pskowronek/unitra-fm-radio-arduino/www/assembled/01.jpg

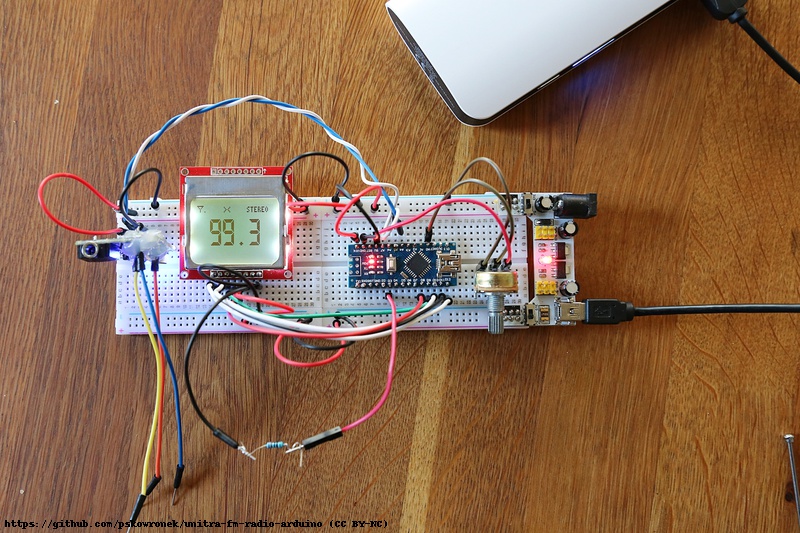
www/assembled/01.jpg
