pskowronek/unitra-fm-radio-arduino/www/assembled/02.jpg

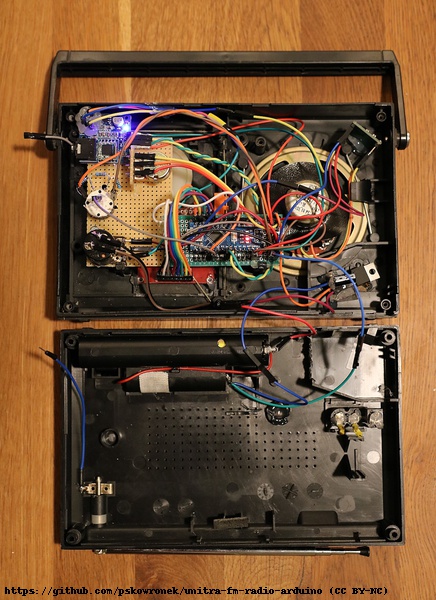
www/assembled/02.jpg
