pskowronek/unitra-fm-radio-arduino/www/assembled/03.jpg

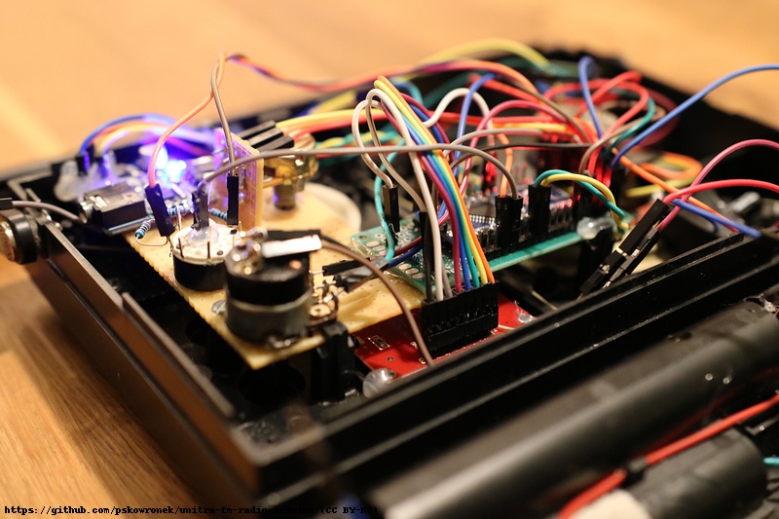
www/assembled/03.jpg
