pskowronek/unitra-fm-radio-arduino/www/assembled/04.jpg

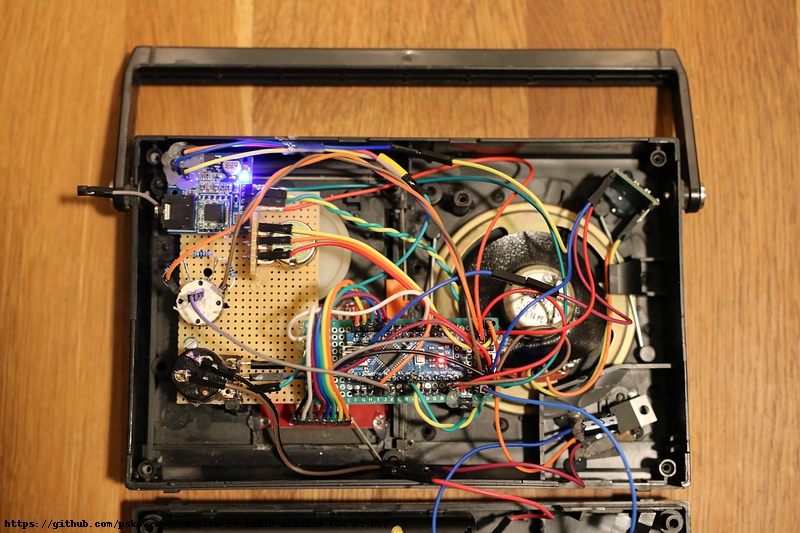
www/assembled/04.jpg
