pskowronek/unitra-fm-radio-arduino/www/assembled/05.jpg

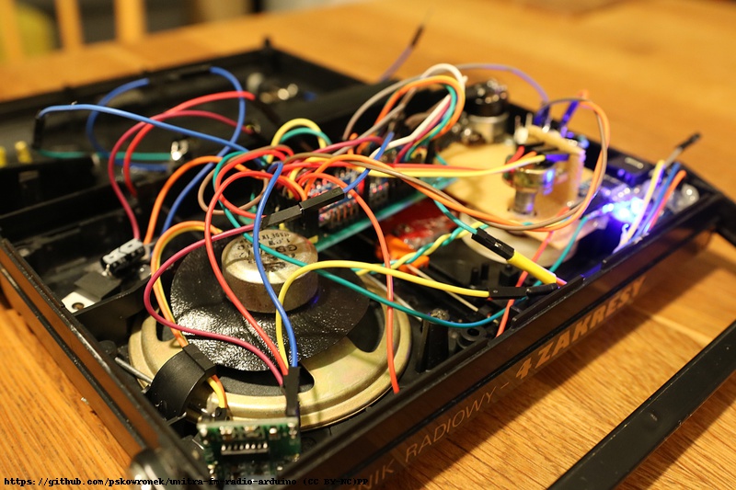
www/assembled/05.jpg
