pskowronek/unitra-fm-radio-arduino/www/assembled/06.jpg

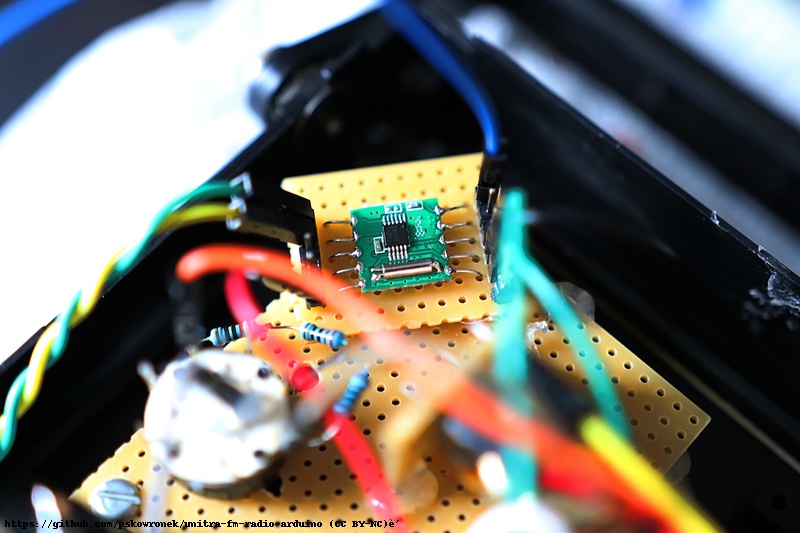
www/assembled/06.jpg
