pskowronek/unitra-fm-radio-arduino/www/assembled/07.jpg

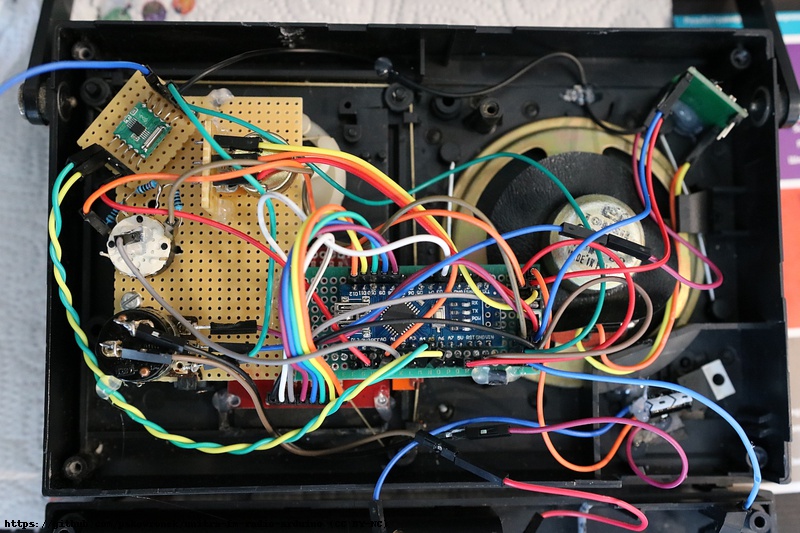
www/assembled/07.jpg
