pskowronek/unitra-fm-radio-arduino/www/assembled/08.jpg

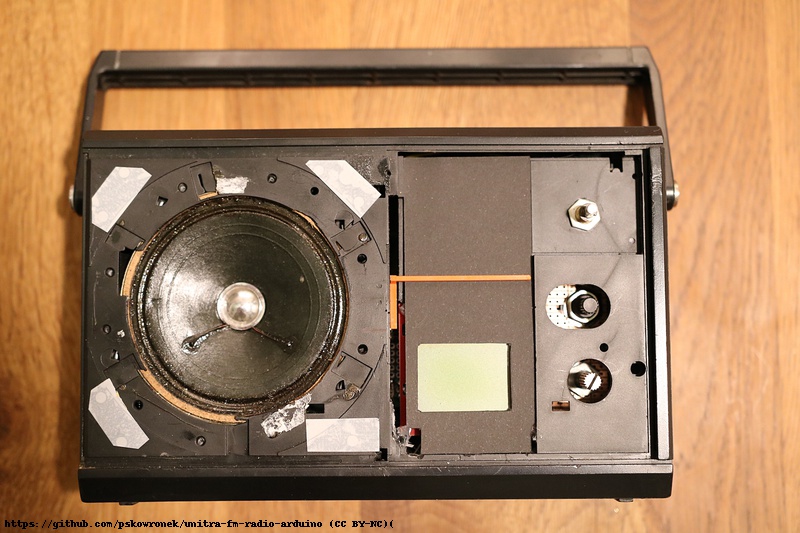
www/assembled/08.jpg
