pskowronek/unitra-fm-radio-arduino/www/assembled/10.jpg

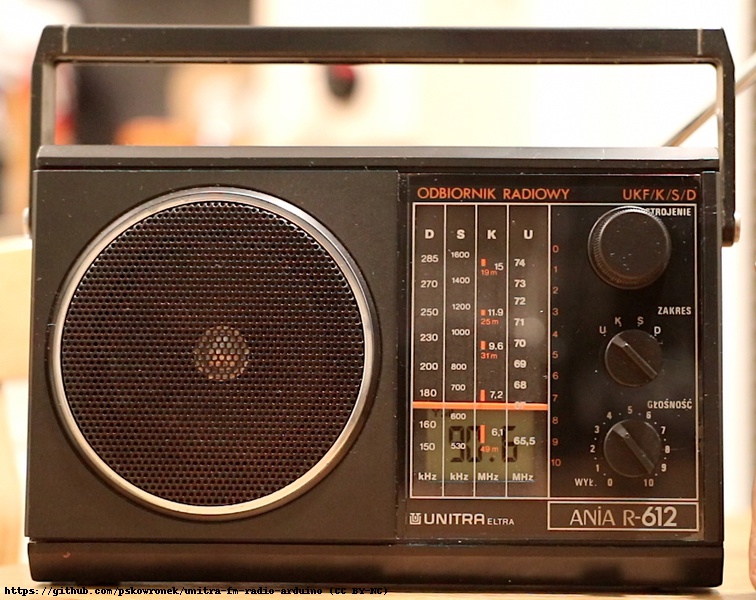
www/assembled/10.jpg
