pskowronek/unitra-fm-radio-arduino/www/assembled/thumbs/01.jpg

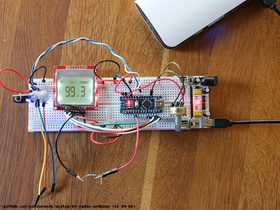
www/assembled/thumbs/01.jpg
