pskowronek/unitra-fm-radio-arduino/www/assembled/thumbs/02.jpg

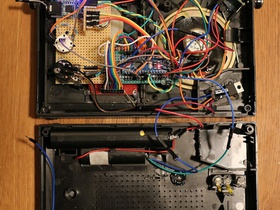
www/assembled/thumbs/02.jpg
