pskowronek/unitra-fm-radio-arduino/www/assembled/thumbs/03.jpg

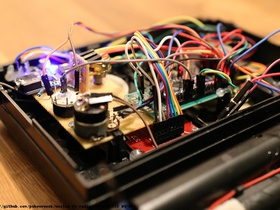
www/assembled/thumbs/03.jpg
