pskowronek/unitra-fm-radio-arduino/www/assembled/thumbs/04.jpg

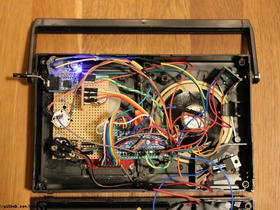
www/assembled/thumbs/04.jpg
