pskowronek/unitra-fm-radio-arduino/www/assembled/thumbs/05.jpg

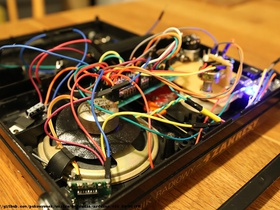
www/assembled/thumbs/05.jpg
