pskowronek/unitra-fm-radio-arduino/www/assembled/thumbs/06.jpg

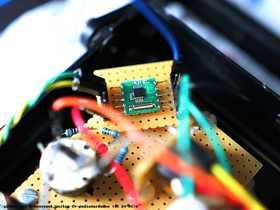
www/assembled/thumbs/06.jpg
