pskowronek/unitra-fm-radio-arduino/www/assembled/thumbs/07.jpg

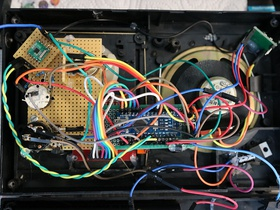
www/assembled/thumbs/07.jpg
