pskowronek/unitra-fm-radio-arduino/www/assembled/thumbs/08.jpg

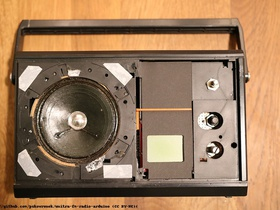
www/assembled/thumbs/08.jpg
