pskowronek/unitra-fm-radio-arduino/www/assembled/thumbs/09.jpg

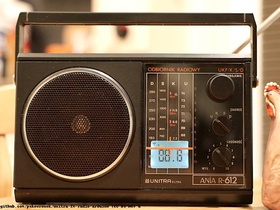
www/assembled/thumbs/09.jpg
