pskowronek/unitra-fm-radio-arduino/splash.c

#include <avr/pgmspace.h>

const unsigned char splash []PROGMEM  = {
0x00, 0x00, 0x00, 0x00, 0x00, 0x00, 0x00, 0x00, 0x00, 0x00, 0x00, 0x00, 0x00, 0x00, 0x00, 0x00,
0x00, 0x00, 0x00, 0x00, 0x00, 0x00, 0x00, 0x00, 0x00, 0x80, 0x80, 0x80, 0x80, 0xC0, 0xC0, 0x40,
0x60, 0x60, 0x20, 0x20, 0x30, 0x10, 0x10, 0x1C, 0x3E, 0x3E, 0x3E, 0x1C, 0x00, 0x00, 0x00, 0x00,
0x00, 0x00, 0x00, 0x00, 0x00, 0x80, 0x80, 0x80, 0x80, 0x80, 0x80, 0x80, 0x80, 0x80, 0x00, 0x80,
0x80, 0x80, 0x80, 0x00, 0x00, 0x00, 0x00, 0x80, 0x80, 0x80, 0x80, 0x00, 0x00, 0x00, 0x00, 0x00,
0x00, 0x00, 0x00, 0x00, 0x00, 0x00, 0x00, 0x00, 0x80, 0xE0, 0xF0, 0xF0, 0xF0, 0xF0, 0xF0, 0x98,
0x98, 0x98, 0x8C, 0x8C, 0x8C, 0x8C, 0x86, 0x86, 0x86, 0x83, 0x83, 0x83, 0x81, 0x81, 0x81, 0x80,
0x80, 0x80, 0x80, 0x80, 0x80, 0x80, 0x80, 0x80, 0x80, 0x80, 0x80, 0x80, 0x80, 0x80, 0x80, 0x00,
0x00, 0x00, 0x00, 0x00, 0x00, 0x00, 0x00, 0x00, 0x00, 0xFF, 0xFF, 0xFF, 0xE3, 0xE3, 0xE3, 0xE3,
0x03, 0x03, 0xE0, 0xFF, 0xFF, 0x7F, 0x7F, 0xFC, 0xE0, 0xC0, 0xF8, 0xFF, 0x1F, 0xFF, 0xFF, 0xFC,
0x00, 0x00, 0x00, 0x00, 0x00, 0x00, 0x00, 0x00, 0x00, 0xFC, 0xFF, 0xFF, 0xFF, 0xFF, 0x1F, 0x0F,
0x0F, 0x0F, 0x1F, 0xBF, 0xFF, 0xFF, 0xFF, 0xFF, 0xFF, 0xFF, 0xFF, 0xFF, 0xFF, 0xFF, 0xFF, 0x7F,
0x3F, 0x3F, 0x1F, 0x1F, 0x0F, 0x4F, 0x4F, 0x4F, 0x4F, 0x4F, 0x0F, 0x1F, 0x1F, 0x3F, 0x7F, 0xFF,
0xFF, 0xFF, 0xFF, 0xFF, 0xFF, 0xFC, 0x00, 0x00, 0x80, 0x80, 0x80, 0x80, 0x80, 0x0F, 0x0F, 0x0F,
0x00, 0x00, 0x80, 0x80, 0x00, 0x00, 0x0F, 0x0F, 0x8F, 0x80, 0x80, 0x87, 0x0F, 0x0F, 0x0F, 0x00,
0x80, 0x8F, 0x0F, 0x0F, 0x00, 0x80, 0x80, 0x80, 0x80, 0x00, 0x00, 0x00, 0x00, 0xFF, 0xFF, 0xFF,
0xFF, 0xFF, 0x3F, 0x1E, 0x1E, 0x1E, 0x1E, 0x7F, 0xFF, 0xFF, 0xFF, 0xFF, 0xFF, 0xFF, 0xFF, 0xFF,
0xFF, 0x9F, 0x01, 0x00, 0x24, 0x26, 0x26, 0x26, 0x26, 0x26, 0x26, 0x26, 0x26, 0x26, 0x26, 0x26,
0x26, 0x24, 0x20, 0x00, 0x03, 0xFF, 0xFF, 0xFF, 0xFF, 0xFF, 0x00, 0x00, 0x3F, 0x3F, 0x0D, 0x1D,
0x3F, 0x27, 0x00, 0x20, 0x38, 0x1F, 0x1B, 0x1F, 0x3E, 0x38, 0x00, 0x00, 0x3F, 0x3F, 0x31, 0x31,
0x1F, 0x0E, 0x00, 0x00, 0x3F, 0x3F, 0x00, 0x0E, 0x1F, 0x31, 0x31, 0x31, 0x31, 0x1F, 0x0E, 0x00,
0x00, 0xFF, 0xFF, 0xFF, 0xFF, 0xFF, 0xFE, 0xFC, 0xFC, 0xFC, 0xFE, 0xFF, 0xFF, 0xFF, 0xFF, 0xFF,
0xFF, 0xFF, 0xFF, 0xFF, 0xFF, 0xFF, 0xFC, 0xF0, 0xE1, 0xE3, 0xC3, 0x83, 0x93, 0x93, 0x93, 0x93,
0x93, 0x93, 0x83, 0xC3, 0xC3, 0xE3, 0xF0, 0xF8, 0xFE, 0xFF, 0xFF, 0xFF, 0xFF, 0xFF, 0x00, 0x00,
0x00, 0x00, 0x00, 0x40, 0xC0, 0x00, 0x00, 0xC0, 0xC0, 0x00, 0x00, 0x00, 0x60, 0xE0, 0xE0, 0x00,
0x00, 0x00, 0x00, 0x00, 0x00, 0x00, 0x80, 0xC0, 0x60, 0x60, 0x60, 0xC0, 0x80, 0x00, 0x00, 0x00,
0x00, 0x00, 0x00, 0x00, 0x00, 0x01, 0x07, 0x0F, 0x0F, 0x0F, 0x0F, 0x0F, 0x0F, 0x0F, 0x0F, 0x0F,
0x0F, 0x0F, 0x0F, 0x0F, 0x0F, 0x0F, 0x0F, 0x0F, 0x0F, 0x0F, 0x0F, 0x0F, 0x0F, 0x0F, 0x0F, 0x0F,
0x0F, 0x0F, 0x0F, 0x0F, 0x0F, 0x0F, 0x0F, 0x0F, 0x0F, 0x0F, 0x0F, 0x0F, 0x0F, 0x0F, 0x0F, 0x0F,
0x07, 0x01, 0x00, 0x00, 0x00, 0x00, 0x00, 0x00, 0x03, 0x0F, 0x0E, 0x07, 0x00, 0x00, 0x00, 0x00,
0x00, 0x0F, 0x0F, 0x00, 0x00, 0x0C, 0x0C, 0x00, 0x00, 0x00, 0x03, 0x07, 0x0C, 0x0C, 0x0C, 0x07,
0x03, 0x00, 0x00, 0x00, 0x00, 0x00, 0x00, 0x00, 
};
