pskowronek/unitra-fm-radio-arduino/icons.c

#if defined(__AVR__)
    #include <avr/pgmspace.h>
    #define imagedatatype const uint8_t
#elif defined(__PIC32MX__)
    #define PROGMEM
    #define imagedatatype const unsigned char
#elif defined(__arm__)
    #define PROGMEM
    #define imagedatatype const unsigned char
#endif

imagedatatype signal5[] PROGMEM={
0xC1, 0xC3, 0xC5, 0xF9, 0xC5, 0xC3, 0xC1, 0xC0, 0xE0, 0xC0, 0xF0, 0xC0, 0xF8, 0xC0, 0xFC, 0xC0,   // 0x0010 (16) pixels
0xFE, 
};

imagedatatype signal4[] PROGMEM={
0xC1, 0xC3, 0xC5, 0xF9, 0xC5, 0xC3, 0xC1, 0xC0, 0xE0, 0xC0, 0xF0, 0xC0, 0xF8, 0xC0, 0xFC, 0xC0,   // 0x0010 (16) pixels
0xC0, 
};

imagedatatype signal3[] PROGMEM={
0xC1, 0xC3, 0xC5, 0xF9, 0xC5, 0xC3, 0xC1, 0xC0, 0xE0, 0xC0, 0xF0, 0xC0, 0xF8, 0xC0, 0xC0, 0xC0,   // 0x0010 (16) pixels
0xC0, 
};

imagedatatype signal2[] PROGMEM={
0xC1, 0xC3, 0xC5, 0xF9, 0xC5, 0xC3, 0xC1, 0xC0, 0xE0, 0xC0, 0xF0, 0xC0, 0xC0, 0xC0, 0xC0, 0xC0,   // 0x0010 (16) pixels
0xC0, 
};

imagedatatype signal1[] PROGMEM={
0xC1, 0xC3, 0xC5, 0xF9, 0xC5, 0xC3, 0xC1, 0xC0, 0xE0, 0xC0, 0xC0, 0xC0, 0xC0, 0xC0, 0xC0, 0xC0,   // 0x0010 (16) pixels
0xC0, 
};
