pskowronek/unitra-fm-radio-arduino/(commit log)

2019-03-17 Initial original import of educ8s.tv/arduino-fm-radio-project
2019-05-10 Second approximation - set predefined stations by rotary switch
2019-05-12 Predefined freq by using rotary switch
2019-05-16 Updated README.md about the wiring
2019-05-18 Updated potentiometers reading after changing how to power the arduino + README.md updates
